roadtothewest/resBot/README.md

# resBot
**Dron de Rescate**

En este repositorio se registrarán los avances, restricciones y decisiones de diseño de arquitectura del robot de rescate. El trabajo paraleliza en los módulos: poder, control, visión y telco.

---

El documento "Carta_Gantt.xlsx" no corresponde a su versión oficial.
