roadtothewest/resBot/Arquitectura y descripciones/Boceto_Arquitectura_Quadcopter.pdf

Proyecto quadcopter para SUAS

Boceto de Arquitectura resBot

Vicente Andrade, Antonio Avendanõ , Cristobal ´ | Fuentes, Alejandro Mena

### Diagrama de Arquitectura

Power Managment Supply

MCU Control Secundario | MCU Telecomunicaciones | Radxa Zero 3w
FOC | Módulo LoRa | Gimbal / Cámara

3V3

3V3 | 5V
SPI | SPI
4 | SPI | SPI | MIPI CSI-2

### 1. Power Management Supply

Queda dise ñar el módulo de alimentación (Baterías para alimentacion independiente). ´

Conexiones: Entrega 5 [V] a la Radxa Zero 3W y 3.3 [V] a la MCU Control Secundario y a la MCU Telecomunicaciones.

### 2. MCU de Telecomunicaciones

Se propone una ESP32 (Queda revisar el modelo).

Conexiones: SPI a Radxa, MCU Control Secundario y Modulo LoRa. ´

### 3. Radxa Zero 3W

Dedicado principalmente al procesamiento digital de imagenes para c ´ | amara. ´

Posee un procesador de cuatro nucleos (SoC) Rockchip RK3566 de bajo consumo que a la ´ vez posee una NPU de 0.8 TOPS integrada.

*Boceto de funcionamiento: Ejecutar YOLO convertido al formato Rockchip (RKNN) y utilizar OpenCV solo para capturar fotogramas y dibujar las bounding boxes.

Queda revisar: 4-8GB de RAM (LPDDR4) para cargar SO, capturar video HD y mantener los tensores YOLO en memoria.

Conexiones: SPI al Modulo de Telecomunicaciones y MIPI CSI-2 a la c ´ | amara mediante FPC. ´

### 4. MCU de Control Secundario

El desarrollo de este módulo será el enfoque del ramo ELO301

Queda revisar el MCU que se utilizará.

Conexiones: SPI a 4 Modulos FOC y a M ´ | odulo Telecomunicaciones. ´

### 5. Módulo LoRa

Se propone un circuito integrado Semtech SX1262 a ∼ 915 [MHz] (Alcance de 15-20 [km]) para recibir comandos remotos y transmitir datos.

Queda revisar módulos comerciales (Ebyte, Hope RF, Waveshare).

Conexiones: SPI a Modulo Telecomunicaciones. ´

### 6. Gimbal y Cámara

Queda revisar el sensor a utilizar (Ej: IMX519-16MP, IMX477-12MP), el módulo que posea este sensor y si este posee un conector FPC con separación entre pines de 0.5 [mm] para Radxa. Revisar si se optará por utilizar un lente teleobjetivo (Zoom óptico).

### 7. Módulos FOC

Queda revisar dise ño e implementación de módulos FOC.

Queda revisar si se utilizará un Gimbal finalmente y si es el caso, cuál se utilizará.

### Enlaces a Componentes

Radxa Zero 3w, (https://radxa.com/products/zeros/zero3w/#techspec) Single Board Computer

SX1262, (https://www.semtech.com/products/wireless-rf/lora-connect/sx1262) LoRa Transceiver

### Componentes a evaluar:

Cámara

IMX519-16MP (https://www.arducam.com/imx519-autofocus-camera-module-for-raspberry-pi-arducam-b0371.html) de Arducam

IMX477-12MP (https://docs.arducam.com/Raspberry-Pi-Camera/Native-camera/12MP-IMX477/#supported-operating-systems) de Arducam

### Glosario

CSI: Camera Serial Interface

FOC: Field Oriented Control

FPC: Flexible Printed Circuit

MCU: MicroController Unit

NPU: Neural Processing Unit

OS: Operative System

PMS: Power Management Supply

RKNN: Rockchip Neural Network

SoC: System On a Chip

SPI: Serial Peripheral Interface

TOPS: Tera Operations per second

YOLO: You Only Look Once (Algoritmo de Vision Computacional) ´
