roadtothewest/resBot/ELO301_Modulo_Control_Secundario/esquematicos/01_Alimentacion.png

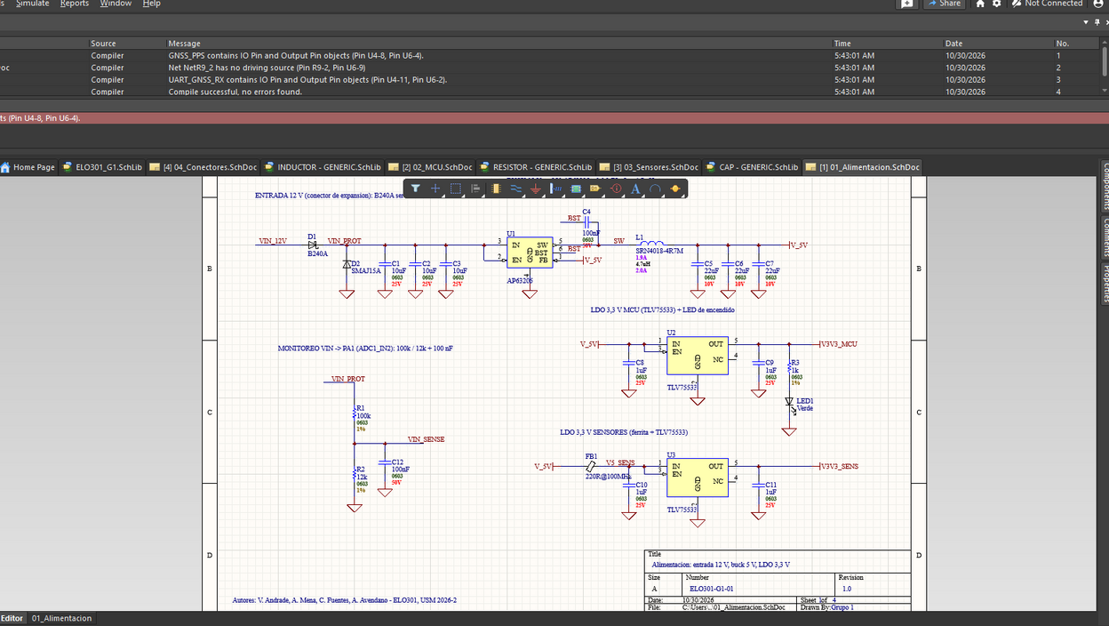
ELO301_Modulo_Control_Secundario/esquematicos/01_Alimentacion.png
