roadtothewest/resBot/ELO301_Modulo_Control_Secundario/esquematicos/02_MCU.png

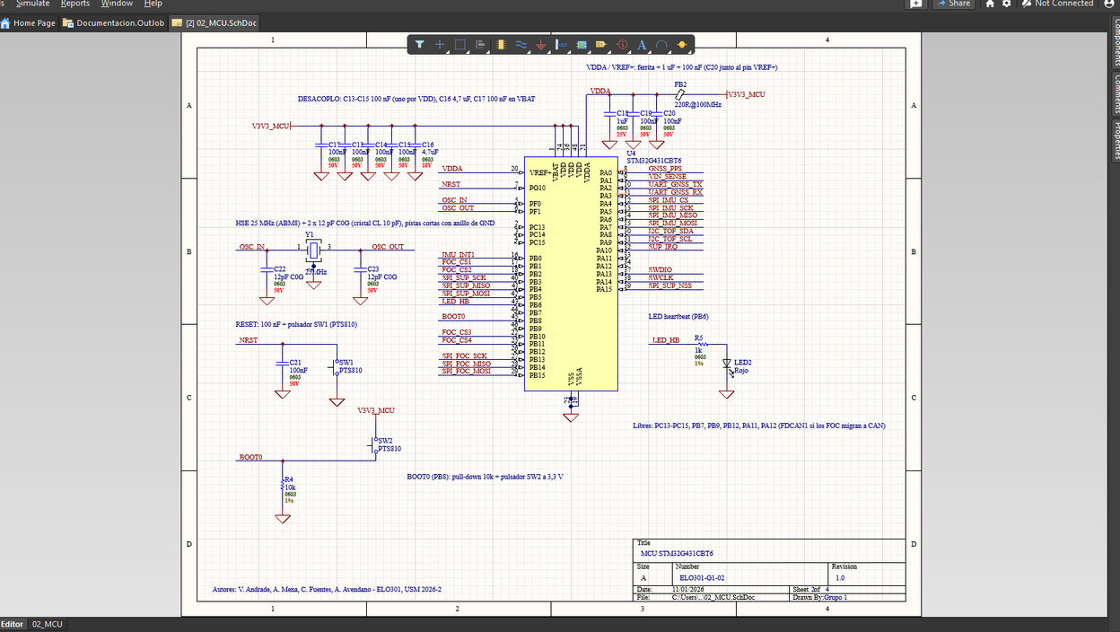
ELO301_Modulo_Control_Secundario/esquematicos/02_MCU.png
