roadtothewest/resBot/ELO301_Modulo_Control_Secundario/esquematicos/03_Sensores.png

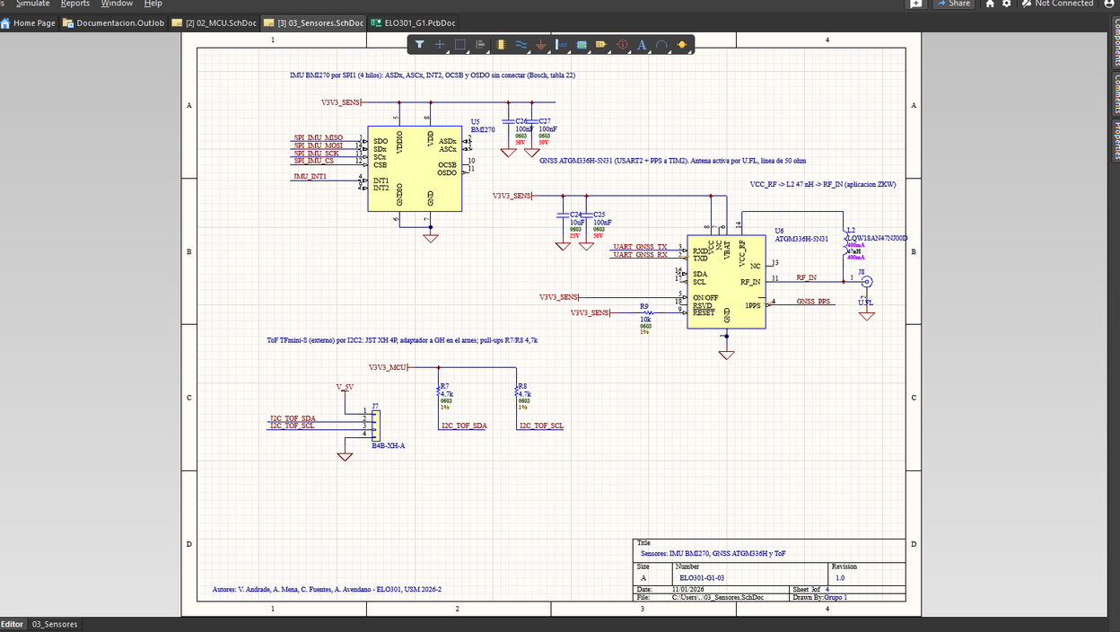
ELO301_Modulo_Control_Secundario/esquematicos/03_Sensores.png
