roadtothewest/resBot/ELO301_Modulo_Control_Secundario/esquematicos/04_Conectores.png

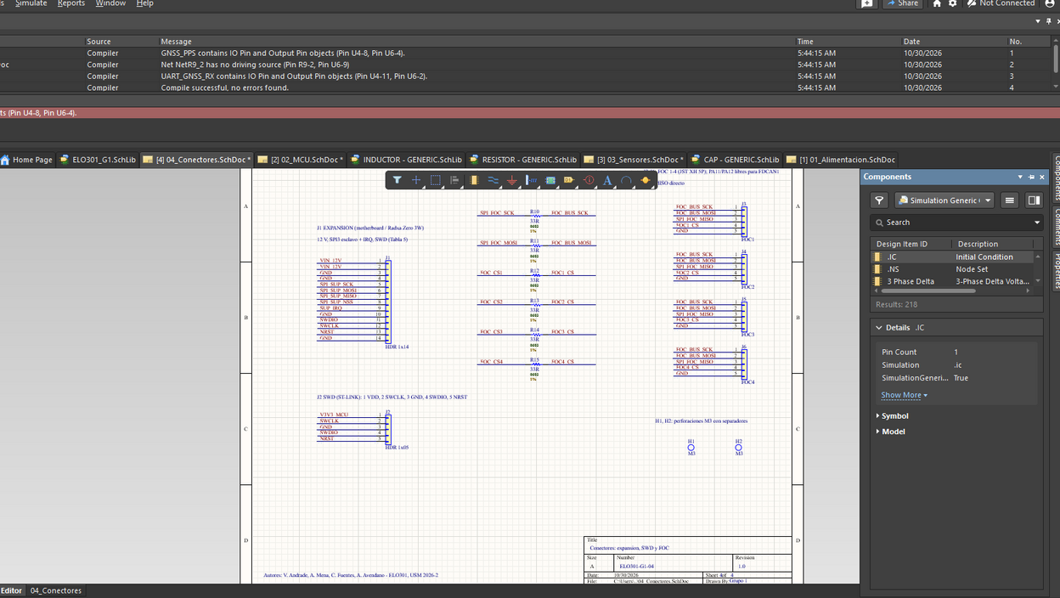
ELO301_Modulo_Control_Secundario/esquematicos/04_Conectores.png
