roadtothewest/resBot/ELO301_Modulo_Control_Secundario/fabricacion/BOM_ELO301_G1.csv

Comment | Designator | Footprint | Manufacturer | Manufacturer Part Number | LCSC Part # | Qty
10uF | C1,C2,C3,C24 | C0603 - MURATA | Murata | GRM188R61E106MA73D | C91606 | 4
100nF | C4,C12,C13,C14,C15,C17,C19,C20,C21,C25,C26,C27 | C0603 - MURATA | Murata | GRM188R71H104KA93D | C77055 | 12
22uF | C5,C6,C7 | C0603 - MURATA | Murata | GRM188R61A226ME15D | C84419 | 3
1uF | C8,C9,C10,C11,C18 | C0603 - MURATA | Murata | GRM188R61E105KA12D | C77046 | 5
4.7uF | C16 | C0603 - MURATA | Murata | GRM188R61A475KE15D | C71633 | 1
12pF C0G | C22,C23 | C0603 - MURATA | Samsung Electro-Mechanics | CL10C120JB8NNNC | C38523 | 2
B240A | D1 | SMA - DIODES | Diodes Inc. | B240A-13-F | C92506 | 1
SMAJ15A | D2 | SMA - DIODES | Diodes Inc. | SMAJ15A-13-F | C110520 | 1
220R@100MHz | FB1,FB2 | L0603 - GENERIC | Murata | BLM18PG221SN1D | C80165 | 2
HDR 1x14 | J1 | HDR 1x14 2.54 - BOOMELE | XFCN | PZ254V-11-14P | C22465874 | 1
HDR 1x05 | J2 | HDR 1x05 2.54 - BOOMELE | XFCN | PZ254V-11-05P | C492404 | 1
FOC1 | J3 | B5B-XH-A - JST | JST | B5B-XH-A(LF)(SN) | C157991 | 1
FOC2 | J4 | B5B-XH-A - JST | JST | B5B-XH-A(LF)(SN) | C157991 | 1
FOC3 | J5 | B5B-XH-A - JST | JST | B5B-XH-A(LF)(SN) | C157991 | 1
FOC4 | J6 | B5B-XH-A - JST | JST | B5B-XH-A(LF)(SN) | C157991 | 1
B4B-XH-A | J7 | B4B-XH-A - JST | JST | B4B-XH-A(LF)(SN) | C144395 | 1
U.FL | J8 | U.FL - HIROSE | Hirose | U.FL-R-SMT-1(10) | C88373 | 1
SRN4018-4R7M | L1 | SRN4018 - BOURNS | Bourns | SRN4018-4R7M | C780206 | 1
LQW18AN47NJ00D | L2 | L0603 - GENERIC | Murata | LQW18AN47NJ00D | C98077 | 1
Verde | LED1 | LED0603 - LITEON | Lite-On | LTST-C191KGKT | C125098 | 1
Rojo | LED2 | LED0603 - LITEON | Lite-On | LTST-C191KRKT | C125099 | 1
100k | R1 | R0603 - YAGEO | Yageo | RC0603FR-07100KL | C14675 | 1
12k | R2 | R0603 - YAGEO | Yageo | RC0603FR-0712KL | C114659 | 1
1k | R3,R5 | R0603 - YAGEO | Yageo | RC0603FR-071KL | C22548 | 2
10k | R4,R9 | R0603 - YAGEO | Yageo | RC0603FR-0710KL | C98220 | 2
4.7k | R7,R8 | R0603 - YAGEO | Yageo | RC0603FR-074K7L | C99782 | 2
33R | R10,R11,R12,R13,R14,R15 | R0603 - YAGEO | Yageo | RC0603FR-0733RL | C108661 | 6
PTS810 | SW1,SW2 | PTS810 - CK | C&K | PTS810 SJM 250 SMTR LFS | C116501 | 2
AP63205 | U1 | TSOT-23-6 - DIODES | Diodes Inc. | AP63205WU-7 | C2071056 | 1
TLV75533 | U2,U3 | SOT-23-5 - TI | Texas Instruments | TLV75533PDBVR | C404027 | 2
STM32G431CBT6 | U4 | LQFP-48 - ST | STMicroelectronics | STM32G431CBT6 | C529355 | 1
BMI270 | U5 | LGA-14 2.5x3.0 - BOSCH | Bosch Sensortec | BMI270 | C2836813 | 1
ATGM336H-5N31 | U6 | LCC-18 9.7x10.1 - ZKW | ZKW (Hangzhou ZhongKe) | ATGM336H-5N31 | C90770 | 1
25MHz | Y1 | ABM8 - ABRACON | Abracon | ABM8-25.000MHZ-10-D1G-T | C5366868 | 1
