roadtothewest/resBot/ELO301_Modulo_Control_Secundario/generadores/digikey/metadatos_digikey.tsv

ID | Designadores | Tipo | LibRef | LibFile | Prefijo | LibOrigen | Comentario | Descripcion | Manufacturer | MPN | Supplier1 | SPN1 | Supplier2 | SPN2 | Category | CasePackage | SupplierDevicePackage | OperatingTemperature | Lifecycle | Datasheet | ProductURL | Extra
C10U | C1,C2,C3,C24 | GENERICO | CAP - GENERIC | CAP - GENERIC.SchLib | C | CAP - GENERIC | 10uF | 10 µF ±20% 25V Ceramic Capacitor X5R 0603 (1608 Metric) | Murata Electronics | GRM188R61E106MA73D | DigiKey | 490-7202-1-ND | LCSC | C91606 | Ceramic Capacitors |  |  | -55°C ~ 85°C | Active | https://mm.digikey.com/Volume0/opasdata/d220001/medias/docus/8942/Chip_Multilayer_CAT2021_MLCC.pdf | https://www.digikey.com/en/products/result?keywords=GRM188R61E106MA73D | Voltage Rating (DC)=25V
C100N | C4,C12,C13,C14,C15,C17,C19,C20,C21,C25,C26,C27 | GENERICO | CAP - GENERIC | CAP - GENERIC.SchLib | C | CAP - GENERIC | 100nF | 0.1 µF ±10% 50V Ceramic Capacitor X7R 0603 (1608 Metric) | Murata Electronics | GCM188R71H104KA57D | DigiKey | 490-4779-1-ND |  |  | Ceramic Capacitors |  |  | -55°C ~ 125°C | Active | https://pim.murata.com/asset/pim4/ceramicCapacitorSMD/GCM188R71H104KA57-01A-EN_PDF_CERAMICCAPACITORSMD | https://www.digikey.com/en/products/result?keywords=GCM188R71H104KA57D | Voltage Rating (DC)=50V
C22U | C5,C6,C7 | GENERICO | CAP - GENERIC | CAP - GENERIC.SchLib | C | CAP - GENERIC | 22uF | 22 µF ±20% 10V Ceramic Capacitor X5R 0603 (1608 Metric) | Murata Electronics | GRM188R61A226ME15D | DigiKey | 490-10476-1-ND | LCSC | C84419 | Ceramic Capacitors |  |  | -55°C ~ 85°C | Active | https://mm.digikey.com/Volume0/opasdata/d220001/medias/docus/8942/490_Chip_Multilayer_CAT2021_MLCC.pdf | https://www.digikey.com/en/products/result?keywords=GRM188R61A226ME15D | Voltage Rating (DC)=10V
C1U | C8,C9,C10,C11,C18 | GENERICO | CAP - GENERIC | CAP - GENERIC.SchLib | C | CAP - GENERIC | 1uF | 1 µF ±10% 25V Ceramic Capacitor X7R 0603 (1608 Metric) | Murata Electronics | GCM188R71E105KA64D | DigiKey | 490-10673-1-ND |  |  | Ceramic Capacitors |  |  | -55°C ~ 125°C | Active | https://pim.murata.com/asset/pim4/ceramicCapacitorSMD/GCM188R71E105KA64-04A-EN_PDF_CERAMICCAPACITORSMD | https://www.digikey.com/en/products/result?keywords=GCM188R71E105KA64D | Voltage Rating (DC)=25V
C4U7 | C16 | GENERICO | CAP - GENERIC | CAP - GENERIC.SchLib | C | CAP - GENERIC | 4.7uF | 4.7 µF ±20% 16V Ceramic Capacitor X5R 0603 (1608 Metric) | Murata Electronics | GRM188R61C475ME11J | DigiKey | 490-GRM188R61C475ME11JCT-ND |  |  | Ceramic Capacitors |  |  | -55°C ~ 85°C | Active | https://pim.murata.com/asset/pim4/ceramicCapacitorSMD/GRM188R61C475ME11-01A-EN_PDF_CERAMICCAPACITORSMD | https://www.digikey.com/en/products/result?keywords=GRM188R61C475ME11J | Voltage Rating (DC)=16V
C12P | C22,C23 | GENERICO | CAP - GENERIC | CAP - GENERIC.SchLib | C | CAP - GENERIC | 12pF C0G | 12 pF ±5% 50V Ceramic Capacitor C0G, NP0 0603 (1608 Metric) | Samsung Electro-Mechanics | CL10C120JB8NNNC | DigiKey | 1276-1254-1-ND | LCSC | C38523 | Ceramic Capacitors |  |  | -55°C ~ 125°C | Active | https://mm.digikey.com/Volume0/opasdata/d220001/medias/docus/3682/CL10C120JB8NNNC_Spec.pdf | https://www.digikey.com/en/products/result?keywords=CL10C120JB8NNNC | Voltage Rating (DC)=50V
D1 | D1 | PARTE | B240A-13-F | DIODE - B240A-13-F.SchLib | D | B240A-13-F | B240A | Schottky Diode 40 V 2A Surface Mount SMA | Diodes Incorporated | B240A-13-F | DigiKey | B240A-FDICT-ND | LCSC | C92506 | Single Diodes | DO-214AC, SMA | SMA | -65°C ~ 150°C | Active | https://www.diodes.com/assets/Datasheets/B220_A-B260_A.pdf | https://www.digikey.com/en/products/result?keywords=B240A-13-F
D2 | D2 | PARTE | SMAJ15A-13-F | TVS - SMAJ15A-13-F.SchLib | D | SMAJ15A-13-F | SMAJ15A | 24.4V Clamp 16.4A Ipp Tvs Diode Surface Mount SMA | Diodes Incorporated | SMAJ15A-13-F | DigiKey | SMAJ15A-FDICT-ND | LCSC | C110520 | TVS Diodes | DO-214AC, SMA | SMA | -55°C ~ 150°C (TJ) | Active | https://www.diodes.com/assets/Datasheets/SMAJ5.0CA-SMAJ200CA.pdf | https://www.digikey.com/en/products/result?keywords=SMAJ15A-13-F
FB | FB1,FB2 | GENERICO | FERRITE - GENERIC | FERRITE - GENERIC.SchLib | FB | FERRITE - GENERIC | 220R@100MHz | 220 Ohms @ 100 MHz 1 Power Line Ferrite Bead 0603 (1608 Metric) 1.4A 100mOhm | Murata Electronics | BLM18PG221SN1D | DigiKey | 490-5221-1-ND | LCSC | C80165 | Ferrite Beads and Chips | 0603 (1608 Metric) |  | -55°C ~ 125°C | Active | https://pim.murata.com/asset/pim4/ferriteBeadInductortypefilter/ENFA0003_PDF_FERRITEBEADINDUCTORTYPEFILTER | https://www.digikey.com/en/products/result?keywords=BLM18PG221SN1D
J1 | J1 | PARTE | BOOMELE 2.54-1x14 | CONN - BOOMELE 2.54-1x14.SchLib | J | CONN - 1x14 | HDR 1x14 | CONN HEADER 40POS 2.54mm SINGLE ROW TH (tira 1x40 cortada a 1x14) | BOOMELE(Boom Precision Elec) | 2.54-1*40P | LCSC | C2337 |  |  | Headers, Male Pins | Through Hole, P=2.54mm |  | -55°C ~ 105°C | Active | https://www.lcsc.com/datasheet/C2337.pdf | https://www.lcsc.com/product-detail/C2337.html | Nota DigiKey=No disponible en DigiKey: estandar del ramo (tira BOOMELE)
J2 | J2 | PARTE | BOOMELE 2.54-1x05 | CONN - BOOMELE 2.54-1x05.SchLib | J | CONN - 1x05 | HDR 1x05 | CONN HEADER 40POS 2.54mm SINGLE ROW TH (tira 1x40 cortada a 1x5) | BOOMELE(Boom Precision Elec) | 2.54-1*40P | LCSC | C2337 |  |  | Headers, Male Pins | Through Hole, P=2.54mm |  | -55°C ~ 105°C | Active | https://www.lcsc.com/datasheet/C2337.pdf | https://www.lcsc.com/product-detail/C2337.html | Nota DigiKey=No disponible en DigiKey: estandar del ramo (tira BOOMELE)
JFOC | J3,J4,J5,J6 | PARTE | B5B-XH-A(LF)(SN) | CONN - B5B-XH-A(LF)(SN).SchLib | J | CONN - 1x05 | B5B-XH-A | Connector Header Through Hole 5 position 0.098" (2.50mm) | JST Sales America Inc. | B5B-XH-A(LF)(SN) | DigiKey | 455-B5B-XH-A-ND | LCSC | C157991 | Headers, Male Pins | Through Hole |  | -25°C ~ 85°C | Active | https://www.jst-mfg.com/product/pdf/eng/eXH.pdf | https://www.digikey.com/en/products/result?keywords=B5B-XH-A
J7 | J7 | PARTE | B4B-XH-A(LF)(SN) | CONN - B4B-XH-A(LF)(SN).SchLib | J | CONN - 1x04 | B4B-XH-A | Connector Header Through Hole 4 position 0.098" (2.50mm) | JST Sales America Inc. | B4B-XH-A(LF)(SN) | DigiKey | 455-B4B-XH-A-ND | LCSC | C144395 | Headers, Male Pins | Through Hole |  | -25°C ~ 85°C | Active | https://www.jst-mfg.com/product/pdf/eng/eXH.pdf | https://www.digikey.com/en/products/result?keywords=B4B-XH-A
J8 | J8 | PARTE | U.FL-R-SMT-1(10) | RF - U.FL-R-SMT-1(10).SchLib | J | U.FL-R-SMT-1(10) | U.FL | U.FL (UMCC) Connector Receptacle, Male Pin 50 Ohms Surface Mount Solder | Hirose Electric Co Ltd | U.FL-R-SMT-1(10) | DigiKey | H11891CT-ND | LCSC | C88373 | Coaxial Connectors (RF) | Surface Mount |  | -40°C ~ 90°C | Active | https://mm.digikey.com/Volume0/opasdata/d220001/medias/docus/8942/HIROS08829-1.pdf | https://www.digikey.com/en/products/result?keywords=U.FL-R-SMT-1(10)
L1 | L1 | GENERICO | INDUCTOR - GENERIC | INDUCTOR - GENERIC.SchLib | L | INDUCTOR - GENERIC | SRN4018-4R7M | 4.7 µH Shielded Drum Core, Wirewound Inductor 1.9 A 84mOhm Max Nonstandard | Bourns Inc. | SRN4018-4R7M | DigiKey | SRN4018-4R7MCT-ND | LCSC | C780206 | Fixed Inductors |  |  | -40°C ~ 125°C | Active | https://www.bourns.com/docs/Product-Datasheets/SRN4018.pdf | https://www.digikey.com/en/products/result?keywords=SRN4018-4R7M
L2 | L2 | GENERICO | INDUCTOR - GENERIC | INDUCTOR - GENERIC.SchLib | L | INDUCTOR - GENERIC | LQW18AN47NJ00D | 47 nH Unshielded Drum Core, Wirewound Inductor 380 mA 290mOhm Max 0603 (1608 Metric) | Murata Electronics | LQW18AN47NJ00D | DigiKey | 490-6895-1-ND | LCSC | C98077 | Fixed Inductors |  |  | -55°C ~ 125°C | Active | https://pim.murata.com/asset/pim4/inductor/JELF243A-0024_PDF_INDUCTOR | https://www.digikey.com/en/products/result?keywords=LQW18AN47NJ00D
LED1 | LED1 | GENERICO | LED - GENERIC | LED - GENERIC.SchLib | LED | LED - GENERIC | Verde | Green 571nm LED Indication - Discrete 2V 0603 (1608 Metric) | Lite-On Inc. | LTST-C191KGKT | DigiKey | 160-1446-1-ND | LCSC | C125098 | LED Indication - Discrete | 0603 (1608 Metric) |  |  | Active | https://optoelectronics.liteon.com/upload/download/DS22-2000-228/LTST-C191KGKT.PDF | https://www.digikey.com/en/products/result?keywords=LTST-C191KGKT
LED2 | LED2 | GENERICO | LED - GENERIC | LED - GENERIC.SchLib | LED | LED - GENERIC | Rojo | Red 631nm LED Indication - Discrete 2V 0603 (1608 Metric) | Lite-On Inc. | LTST-C191KRKT | DigiKey | 160-1447-1-ND | LCSC | C125099 | LED Indication - Discrete | 0603 (1608 Metric) |  |  | Active | https://optoelectronics.liteon.com/upload/download/DS22-2000-223/LTST-C191KRKT.PDF | https://www.digikey.com/en/products/result?keywords=LTST-C191KRKT
R100K | R1 | GENERICO | RESISTOR - GENERIC | RESISTOR - GENERIC.SchLib | R | RESISTOR - GENERIC | 100k | 100 kOhms ±1% 0.1W, 1/10W Chip Resistor 0603 (1608 Metric) Moisture Resistant Thick Film | YAGEO | RC0603FR-07100KL | DigiKey | 311-100KHRCT-ND | LCSC | C14675 | Chip Resistor - Surface Mount |  |  | -55°C ~ 155°C | Active | https://yageogroup.com/content/datasheet/asset/file/PYU-RC_GROUP_51_ROHS_L | https://www.digikey.com/en/products/result?keywords=RC0603FR-07100KL
R12K | R2 | GENERICO | RESISTOR - GENERIC | RESISTOR - GENERIC.SchLib | R | RESISTOR - GENERIC | 12k | 12 kOhms ±1% 0.1W, 1/10W Chip Resistor 0603 (1608 Metric) Moisture Resistant Thick Film | YAGEO | RC0603FR-0712KL | DigiKey | 311-12.0KHRCT-ND | LCSC | C114659 | Chip Resistor - Surface Mount |  |  | -55°C ~ 155°C | Active | https://yageogroup.com/content/datasheet/asset/file/PYU-RC_GROUP_51_ROHS_L | https://www.digikey.com/en/products/result?keywords=RC0603FR-0712KL
R1K | R3,R5 | GENERICO | RESISTOR - GENERIC | RESISTOR - GENERIC.SchLib | R | RESISTOR - GENERIC | 1k | 1 kOhms ±1% 0.1W, 1/10W Chip Resistor 0603 (1608 Metric) Moisture Resistant Thick Film | YAGEO | RC0603FR-071KL | DigiKey | 311-1.00KHRCT-ND | LCSC | C22548 | Chip Resistor - Surface Mount |  |  | -55°C ~ 155°C | Active | https://yageogroup.com/content/datasheet/asset/file/PYU-RC_GROUP_51_ROHS_L | https://www.digikey.com/en/products/result?keywords=RC0603FR-071KL
R10K | R4,R9 | GENERICO | RESISTOR - GENERIC | RESISTOR - GENERIC.SchLib | R | RESISTOR - GENERIC | 10k | 10 kOhms ±1% 0.1W, 1/10W Chip Resistor 0603 (1608 Metric) Moisture Resistant Thick Film | YAGEO | RC0603FR-0710KL | DigiKey | 311-10.0KHRCT-ND | LCSC | C98220 | Chip Resistor - Surface Mount |  |  | -55°C ~ 155°C | Active | https://yageogroup.com/content/datasheet/asset/file/PYU-RC_GROUP_51_ROHS_L | https://www.digikey.com/en/products/result?keywords=RC0603FR-0710KL
R4K7 | R7,R8 | GENERICO | RESISTOR - GENERIC | RESISTOR - GENERIC.SchLib | R | RESISTOR - GENERIC | 4.7k | 4.7 kOhms ±1% 0.1W, 1/10W Chip Resistor 0603 (1608 Metric) Moisture Resistant Thick Film | YAGEO | RC0603FR-074K7L | DigiKey | 311-4.70KHRCT-ND | LCSC | C99782 | Chip Resistor - Surface Mount |  |  | -55°C ~ 155°C | Active | https://yageogroup.com/content/datasheet/asset/file/PYU-RC_GROUP_51_ROHS_L | https://www.digikey.com/en/products/result?keywords=RC0603FR-074K7L
R33 | R10,R11,R12,R13,R14,R15 | GENERICO | RESISTOR - GENERIC | RESISTOR - GENERIC.SchLib | R | RESISTOR - GENERIC | 33R | 33 Ohms ±1% 0.1W, 1/10W Chip Resistor 0603 (1608 Metric) Moisture Resistant Thick Film | YAGEO | RC0603FR-0733RL | DigiKey | 13-RC0603FR-0733RLCT-ND | LCSC | C108661 | Chip Resistor - Surface Mount |  |  | -55°C ~ 155°C | Active | https://yageogroup.com/content/datasheet/asset/file/PYU-RC_GROUP_51_ROHS_L | https://www.digikey.com/en/products/result?keywords=RC0603FR-0733RL
SW | SW1,SW2 | PARTE | PTS810 SJM 250 SMTR LFS | SW - PTS810 SJM 250 SMTR LFS.SchLib | SW | PTS810 SJM 250 SMTR LFS | PTS810 | Tactile Switch SPST-NO Top Actuated Surface Mount | C&K | PTS810 SJM 250 SMTR LFS | DigiKey | CKN10502CT-ND | LCSC | C116501 | Tactile Switches | 4.20mm x 3.20mm |  | -40°C ~ 85°C | Active | https://www.littelfuse.com/assetdocs/littelfuse-c-k-tactile-pts810-series-datasheet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 | https://www.digikey.com/en/products/result?keywords=PTS810%20SJM%20250%20SMTR%20LFS
U1 | U1 | PARTE | AP63205WU-7 | BUCK - AP63205WU-7.SchLib | U | AP63205WU-7 | AP63205 | Buck Switching Regulator IC Positive Fixed 5V 1 Output 2A SOT-23-6 Thin, TSOT-23-6 | Diodes Incorporated | AP63205WU-7 | DigiKey | AP63205WU-7DICT-ND | LCSC | C2071056 | Voltage Regulators - DC DC Switching Regulators | SOT-23-6 Thin, TSOT-23-6 | TSOT-23-6 | -40°C ~ 85°C (TA) | Active | https://www.diodes.com/assets/Datasheets/AP63200-AP63201-AP63203-AP63205.pdf | https://www.digikey.com/en/products/result?keywords=AP63205WU-7
ULDO | U2,U3 | PARTE | TLV75533PDBVR | LDO - TLV75533PDBVR.SchLib | U | TLV75533PDBVR | TLV75533 | Linear Voltage Regulator IC Positive Fixed 1 Output 500mA SOT-23-5 | Texas Instruments | TLV75533PDBVR | DigiKey | 296-50411-1-ND | LCSC | C404027 | Voltage Regulators - Linear, Low Drop Out (LDO) Regulators | SC-74A, SOT-753 | SOT-23-5 | -40°C ~ 125°C (TJ) | Active | https://www.ti.com/lit/ds/symlink/tlv755p.pdf | https://www.digikey.com/en/products/result?keywords=TLV75533PDBVR
U4 | U4 | PARTE | STM32G431CBT6 | MCU - STM32G431CBT6.SchLib | U | STM32G431CBT6 | STM32G431CBT6 | ARM® Cortex®-M4F STM32G4 Microcontroller IC 32-Bit 170MHz 128KB (128K x 8) FLASH 48-LQFP (7x7) | STMicroelectronics | STM32G431CBT6 | DigiKey | 497-19473-ND | LCSC | C529355 | Microcontrollers | 48-LQFP | 48-LQFP (7x7) | -40°C ~ 85°C (TA) | Active | https://www.st.com/resource/en/datasheet/stm32g431cb.pdf | https://www.digikey.com/en/products/result?keywords=STM32G431CBT6
U5 | U5 | PARTE | BMI270 | IMU - BMI270.SchLib | U | BMI270 | BMI270 | Accelerometer, Gyroscope, 6 Axis Sensor I2C, SPI Output | Bosch Sensortec | BMI270 | DigiKey | 828-1091-1-ND | LCSC | C2836813 | IMUs (Inertial Measurement Units) | 14-VFLGA | 14-LGA (2.5x3) | -40°C ~ 85°C | Active | https://www.bosch-sensortec.com/media/boschsensortec/downloads/datasheets/bst-bmi270-ds000.pdf | https://www.digikey.com/en/products/result?keywords=BMI270
U6 | U6 | PARTE | ATGM336H-5N31 | GNSS - ATGM336H-5N31.SchLib | U | ATGM336H-5N31 | ATGM336H-5N31 | BDS/GNSS All-constellation Positioning and Navigation Module | ZHONGKEWEI | ATGM336H-5N31 | LCSC | C90770 |  |  | RF Receivers | SMD, 10.1x9.7mm |  | -40°C ~ 85°C | Active | https://www.lcsc.com/datasheet/C90770.pdf | https://www.lcsc.com/product-detail/C90770.html | Nota DigiKey=No disponible en DigiKey: excepcion documentada (como el U.FL en el documento de diseno)
Y1 | Y1 | PARTE | ABM8-25.000MHZ-10-D1G-T | XTAL - ABM8-25.000MHZ-10-D1G-T.SchLib | Y | ABM8-25.000MHZ-B2-T | 25MHz | 25 MHz ±10ppm Crystal 10pF 50 Ohms 4-SMD, No Lead | Abracon LLC | ABM8-25.000MHZ-10-D1G-T | DigiKey | 535-13468-1-ND | LCSC | C5366868 | Crystals | 4-SMD, No Lead | 4-SMD (3.2x2.5) | -40°C ~ 85°C | Active | https://mm.digikey.com/Volume0/opasdata/d220001/medias/docus/6536/ABM8_Datasheet.pdf | https://www.digikey.com/en/products/result?keywords=ABM8-25.000MHZ-10-D1G-T
H | H1,H2 | PARTE | MOUNTING HOLE - M3 | MOUNTING HOLE - M3.SchLib | H | MOUNTING HOLE - M3 | M3 | Mounting Hole without connection, M3
