roadtothewest/resBot/(list of files, drawings)

Other design files:
ELO301_Modulo_Control_Secundario/altium/01_Alimentacion.SchDoc
ELO301_Modulo_Control_Secundario/altium/02_MCU.SchDoc
ELO301_Modulo_Control_Secundario/altium/03_Sensores.SchDoc
ELO301_Modulo_Control_Secundario/altium/04_Conectores.SchDoc
ELO301_Modulo_Control_Secundario/altium/BUCK - AP63205WU-7.SchLib
ELO301_Modulo_Control_Secundario/altium/C0603 - MURATA.PcbLib
ELO301_Modulo_Control_Secundario/altium/CAP - GENERIC.SchLib
ELO301_Modulo_Control_Secundario/altium/CONN - B4B-XH-A(LF)(SN).SchLib
ELO301_Modulo_Control_Secundario/altium/CONN - B5B-XH-A(LF)(SN).SchLib
ELO301_Modulo_Control_Secundario/altium/CONN - BOOMELE 2.54-1x05.SchLib
ELO301_Modulo_Control_Secundario/altium/CONN - BOOMELE 2.54-1x14.SchLib
ELO301_Modulo_Control_Secundario/altium/DIODE - B240A-13-F.SchLib
ELO301_Modulo_Control_Secundario/altium/DIODE - GENERIC.SchLib
ELO301_Modulo_Control_Secundario/altium/ELO301_G1.PcbDoc
ELO301_Modulo_Control_Secundario/altium/ELO301_G1.PcbLib
ELO301_Modulo_Control_Secundario/altium/ELO301_G1.PrjPcb
ELO301_Modulo_Control_Secundario/altium/FERRITE - GENERIC.SchLib
ELO301_Modulo_Control_Secundario/altium/GNSS - ATGM336H-5N31.SchLib
ELO301_Modulo_Control_Secundario/altium/IMU - BMI270.SchLib
ELO301_Modulo_Control_Secundario/altium/INDUCTOR - GENERIC.SchLib
ELO301_Modulo_Control_Secundario/altium/LDO - TLV75533PDBVR.SchLib
ELO301_Modulo_Control_Secundario/altium/LED - GENERIC.SchLib
ELO301_Modulo_Control_Secundario/altium/MCU - STM32G431CBT6.SchLib
ELO301_Modulo_Control_Secundario/altium/MOUNTING HOLE - M3.SchLib
ELO301_Modulo_Control_Secundario/altium/R0603 - YAGEO.PcbLib
ELO301_Modulo_Control_Secundario/altium/RESISTOR - GENERIC.SchLib
ELO301_Modulo_Control_Secundario/altium/RF - U.FL-R-SMT-1(10).SchLib
ELO301_Modulo_Control_Secundario/altium/SW - PTS810 SJM 250 SMTR LFS.SchLib
ELO301_Modulo_Control_Secundario/altium/TVS - SMAJ15A-13-F.SchLib
ELO301_Modulo_Control_Secundario/altium/XTAL - ABM8-25.000MHZ-10-D1G-T.SchLib
