roadtothewest/resBot/(commit log)

2026-07-15 hola Ale
    [Carta_Gantt.xlsx]
2026-07-18 Se agregan carpetas para registrar avances, referencias y documentación
2026-07-20 roadmaps tel y control, gantt actualizada
    [Carta_Gantt_toneto.xlsx]
2026-09-04 Upload Boceto Arquitectura
    Archivo de arquitectura y especificaciones generales para el resBot
2026-10-30 ELO301: esquemático del módulo de control secundario (Altium, G1)
    Proyecto Altium Designer 26 del módulo de control secundario del resBot según el
    Documento de Diseño v5: 4 hojas (alimentación, MCU, sensores, conectores), 68
    componentes con huella y número de parte, ERC sin errores. Incluye las bibliotecas
    (RCL del profesor + 16 símbolos y 17 huellas convertidos desde KiCad 10), imágenes
    de las hojas, los generadores usados y los documentos de diseño y especificaciones.
    [01_Alimentacion.SchDoc, 02_MCU.SchDoc, 03_Sensores.SchDoc, 04_Conectores.SchDoc, C0603 - MURATA.PcbLib, CAP - GENERIC.SchLib, DIODE - GENERIC.SchLib, ELO301_G1.PcbDoc]
2026-10-30 ELO301: PCB de 4 capas ruteado, DRC 0 violaciones; scripts de colocación, ruteo y control de Altium
    [01_Alimentacion.SchDoc, 02_MCU.SchDoc, 03_Sensores.SchDoc, 04_Conectores.SchDoc, ELO301_G1.PcbDoc, ELO301_G1.PcbLib]
2026-10-31 ELO301 PCB: nodos críticos en Top sin vías (SW, BST, OSC_OUT, RF_IN), DRC 0
    L1 girada 180° y L2 junto a la línea RF. SW 6,0 mm, OSC_OUT 6,4 mm, RF_IN 5,0 mm.
    [ELO301_G1.PcbDoc]
2026-10-31 ELO301 PCB: salidas de fabricación (Gerber, taladro, Pick&Place, BOM) y Fabricacion.OutJob
    [BOM_ELO301_G1.csv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]
2026-10-31 ELO301 PCB: 63 vías de costura de GND, DRC 0, Gerber y taladro regenerados
    [ELO301_G1.GBL, ELO301_G1.GBO, ELO301_G1.GBP, ELO301_G1.GBS, ELO301_G1.GTL, ELO301_G1.GTO, ELO301_G1.GTP, ELO301_G1.GTS]
2026-11-01 ELO301: paquete Altium por etapas importable y verificación de impedancia de RF_IN
2026-11-01 ELO301: auditoría del PCB — Gerber corregidos y verificados, paquete JLCPCB, cristal de 10 pF y L2 bobinada
    - Fabricacion.OutJob: «add to all plots» mezclaba todas las capas en cada Gerber y el plot centrado en el film
    desalineaba el taladro; reescrito con las claves de Altium 26 (origen relativo, sin centrar, sin pad master)
    - jlcpcb.py: plano GND en positivo (.G2L), Señal-Potencia .G3L, contorno .GKO y CPL en mm; verifica alineación,
    antipads/alivios y que las capas no se mezclen
    - Y1 ABM8-25.000MHZ-10-D1G-T y C22/C23 de 12 pF (gm crítico 0,83 mA/V); L2 LQW18AN47NJ00D (SRF >= 2,6 GHz)
    - Power Plane Clearance de 0,3 mm; designador de L2 fuera de la máscara de U6; identificació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
    [02_MCU.SchDoc, 03_Sensores.SchDoc, BOM_ELO301_G1.csv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]
2026-11-01 ELO301: LCSC verificados, Update PCB, anillo interno de J1-1 y paquete probado en JLCPCB
    - BOM con LCSC para las 34 líneas, verificados contra la API de piezas de JLCPCB (MPN y stock).
    C22/C23 pasan a Samsung CL10C120JB8NNNC (el Murata no tiene stock) y J1/J2 a headers XFCN de 14 y 5 pines.
    - Gm del HSE confirmado en DS12589 (tabla 42): máx. 1,5 mA/V; el ABM8 de 10 pF da 0,83 mA/V.
    - LCSC y MPN escritos en el esquemático y llevados a la placa con Update PCB. El ECO borraba las clases
    Alimentacion y Potencia (solo de la placa): repuestas con clases_red.py, DRC 0.
    - El .G1 anterior omitía el pad interno de J1-1: la pista de 12 V hacia J1-2 quedaba sin anillo. Salidas
    regeneradas con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
    [01_Alimentacion.SchDoc, 02_MCU.SchDoc, 03_Sensores.SchDoc, 04_Conectores.SchDoc, BOM_ELO301_G1.csv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]
2026-11-02 ELO301: símbolos con metadatos de DigiKey, una biblioteca por pieza
    - 17 SchLib <TIPO> - <MPN>, como en el proyecto de referencia del profesor, a partir de ELO301_G1.SchLib (eliminada):
    un símbolo por archivo, designador por tipo, huella enlazada y parámetros de DigiKey (Supplier 1 / Supplier Part
    Number 1, descripción, categoría, encapsulado, temperatura, estado y hoja de datos). LCSC pasa a Supplier 2.
    - Los 66 componentes de las 4 hojas, enlazados a su biblioteca y con los mismos parámetros; sin LCSC Part #.
    - Capacitores obsoletos en DigiKey reemplazados: 100 nF por GCM188R71H104KA57D, 1 µF por GCM188R71E105KA64D y
    4,7 µF por GRM188R61C475ME11J (16 V).
    - ATGM336H y J1/J2 (t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
    [01_Alimentacion.SchDoc, 02_MCU.SchDoc, 03_Sensores.SchDoc, 04_Conectores.SchDoc, BUCK - AP63205WU-7.SchLib, CONN - B4B-XH-A(LF)(SN).SchLib, CONN - B5B-XH-A(LF)(SN).SchLib, CONN - BOOMELE 2.54-1x05.SchLib]
2026-11-02 ELO301: etapa 4 del paquete sin el OutJob que mezclaba capas
    La etapa 4 pasa a llamarse 4_costura_gnd y conserva la placa con la costura de
    GND. El único Fabricacion.OutJob del paquete es el verificado de la etapa 5.
2026-11-02 ELO301: Update PCB, GND en capa 3, 4 M3, C3 junto al buck y LDO de sensores reubicado
    - Update PCB con los parámetros de DigiKey. El ECO vuelve a quitar las clases Potencia y Alimentacion:
    Placa.pas (ClasesDeRed) las repone.
    - Pour de GND en Senal-Potencia: las pistas de Bottom quedan con referencia a 0,21 mm (antes 1,27 mm).
    - H3 y H4 (M3) en el esquemático y en la placa en (3,3 ; 38,6) y (66,7 ; 38,6) mm: el borde de los FOC deja
    de estar en voladizo a 46 mm. Las coordenadas hay que coordinarlas con la motherboard.
    - C3 entre VIN y GND del AP63205 (lazo de entrada mínimo); el ramal de VIN_PROT al divisor sale desde C3.
    - U3, FB1, C10 y C11 entre la IMU y el GNSS: V3V3_SENS baja de 1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
    [04_Conectores.SchDoc, ELO301_G1.PcbDoc]
2026-11-02 ELO301: lista de pendientes en el README
    Fabricación, coordinación de H3/H4 con la motherboard, documento de diseño v6, método del ramo (ActiveBOM, huellas
    con el wizard, esquemático jerárquico), interfaz de servicio, clases de red y rama V3V3_SENS a la IMU.
